oxplot/fpx/configurer/Readme.md

fpx configuration is done via light pulses that is read by the onboard
sensor.

TODO: explanation of the configuration format and encoding
