oxplot/fpx/.github/social.png

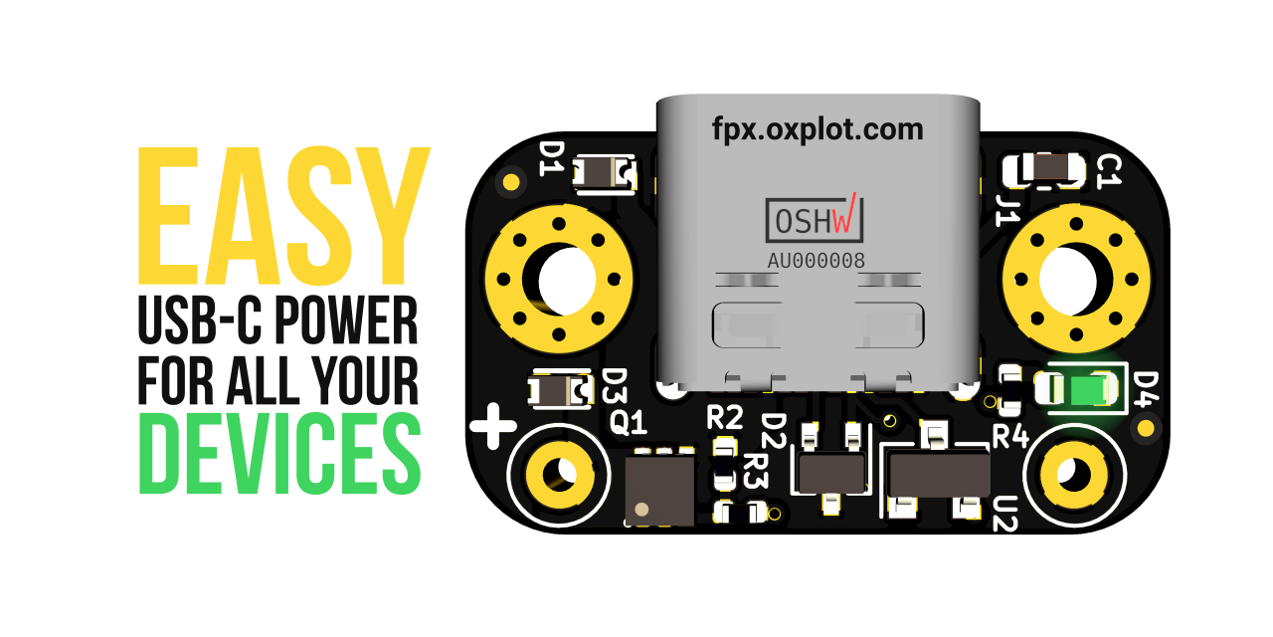
.github/social.png
