oxplot/fpx/configurer/web/fpx.png

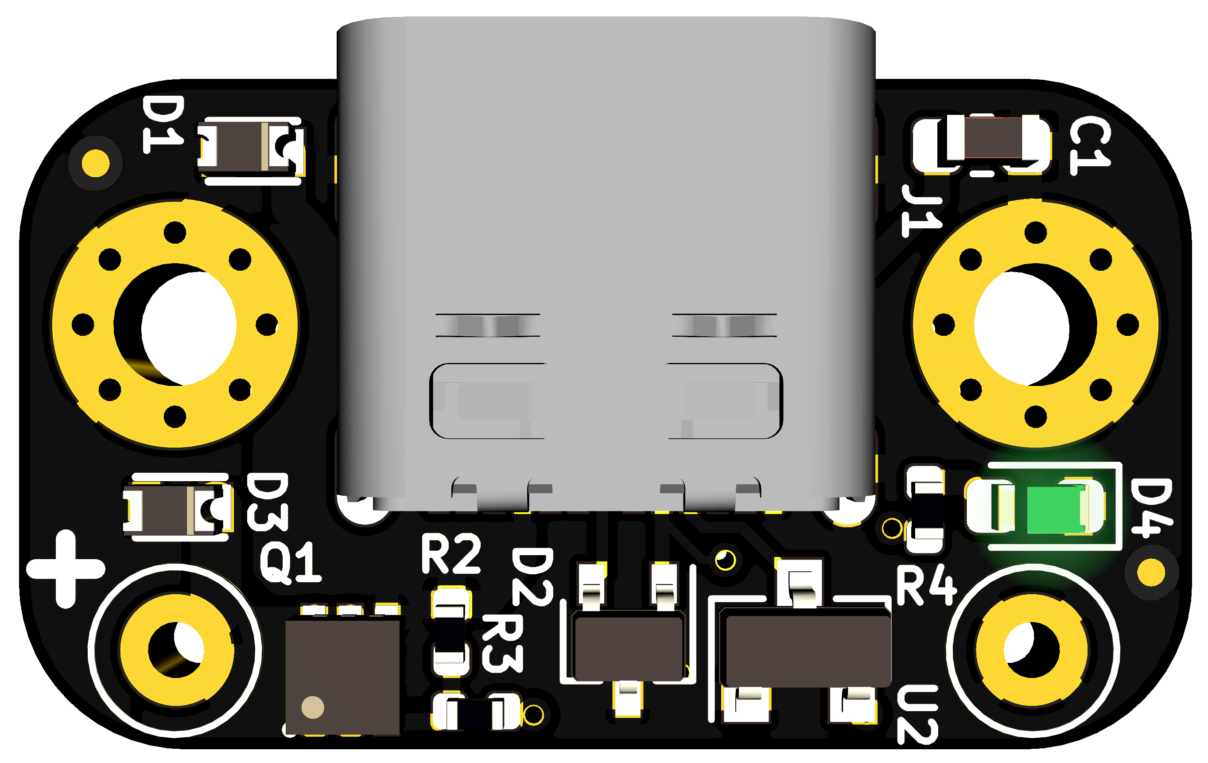
configurer/web/fpx.png
