oxplot/fpx/configurer/web/pwa-screenshot1.png

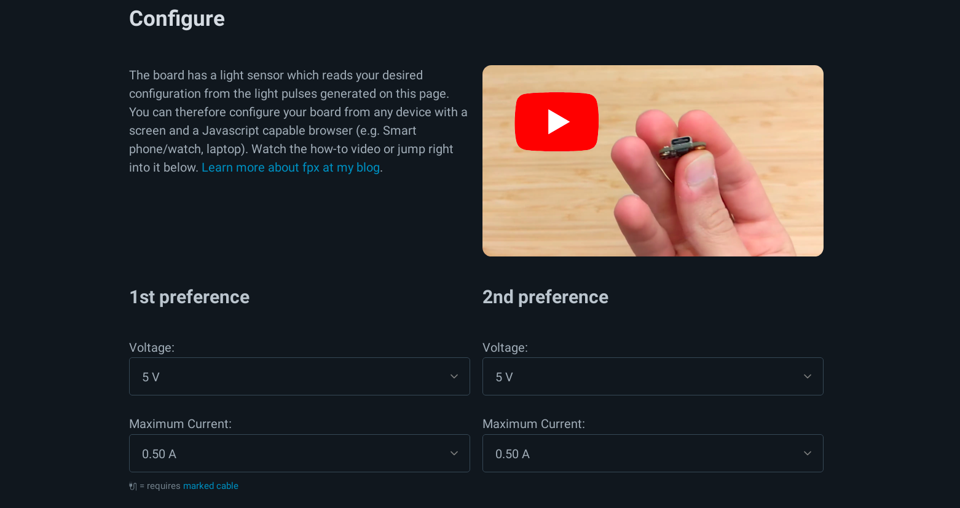
configurer/web/pwa-screenshot1.png
