oxplot/fpx/board/MOLEX_105450-0101.step

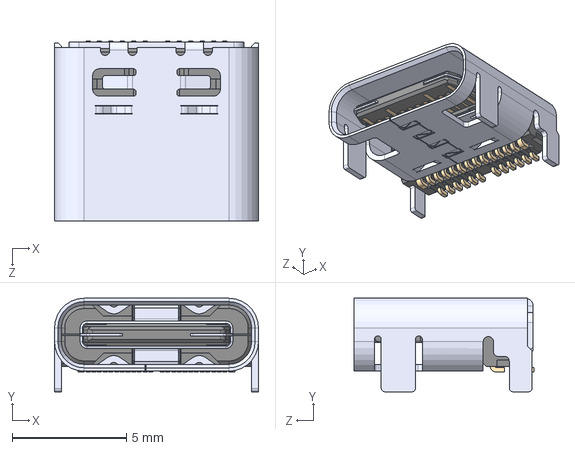
[picture p7: CAD file, 2020-08-21]
board/MOLEX_105450-0101.step
8.94 x 4.10 x 7.90 mm
