oxplot/fpx/programmer/fpx_rev97_prog_jig.step

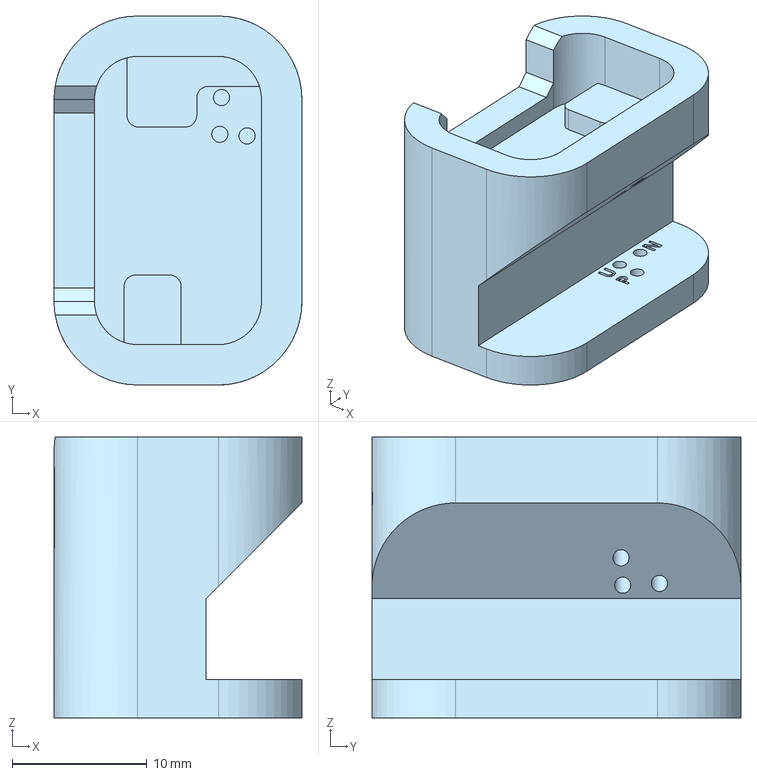
[picture p8: CAD file, 2021-04-24]
programmer/fpx_rev97_prog_jig.step
18.4 x 27.4 x 20.9 mm
