oxplot/fpx/programmer/fpx_rev66_prog_jig.step

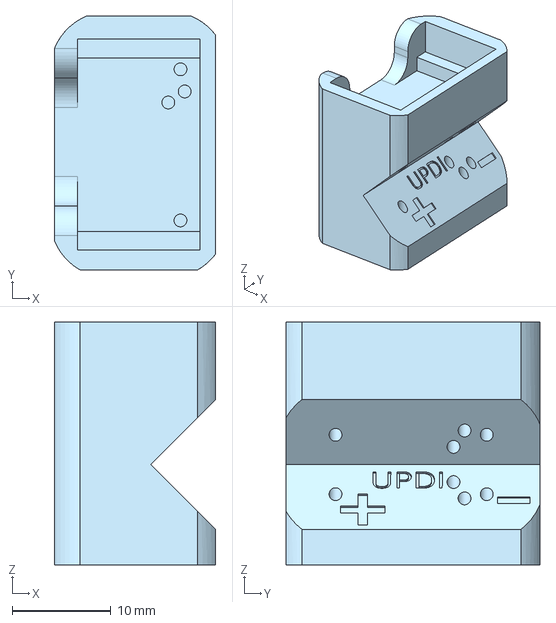
[picture p9: CAD file, 2020-08-21, an earlier design]
programmer/fpx_rev66_prog_jig.step
16.4 x 25.8 x 24.6 mm
