oxplot/fpx/(list of files, cad)

Other CAD files:
programmer/fpx_rev66_prog_jig.stl
programmer/fpx_rev97_prog_jig.stl
