oxplot/fpx/(threads)

Thread 10 (2020-08-27):

Add current limiter and soft-start

oxplot, 2020-08-27:
https://au.element14.com/c/semiconductors-ics/power-management-ics-pmic/power-distribution-switches

https://www.digikey.com/products/en/integrated-circuits-ics/pmic-power-distribution-switches-load-drivers/726

https://www.digikey.com/product-detail/en/stmicroelectronics/VN7140ASTR/497-15994-6-ND/5431502

## Example circuit

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

oxplot, 2020-09-20:
Schematics done in https://github.com/oxplot/fpx/commit/06e6602907f6ecd1e7ba80dc628277a3dda371b2

Closed 2020-09-21.

Thread 11 (2020-08-27):

Add a board level decoupling tantalum capacitor on the VBUS side

oxplot, 2020-08-27:

oxplot, 2020-09-20:
Schematics done in https://github.com/oxplot/fpx/commit/06e6602907f6ecd1e7ba80dc628277a3dda371b2

Closed 2020-09-21.

Thread 14 (2020-09-03):

Backfeeding from Vdrive to Vbus

zoe1337, 2020-09-03:
I was surprised there is no back-to-back MOSFET in the power path - I know this is meant to be a power sink, but if enough bulk capacitance is connected to it, someone might plug it into a port while the caps are still charged.

oxplot, 2020-09-03:
I'd expect the power supply to have its power path protected by a back-to-back MOSFET. Is there any concern of damage to this board?

zoe1337, 2020-09-03:
With standards-compliant devices it should not be an issue.

oxplot, 2020-09-03:
I see. I'll keep this issue as an improvement for the next version. Also, the typical application schematics of STUSB4500 features the back-to-back MOSFET as well:

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

Thanks for bringing this up.

Closed 2022-12-30.

Thread 16 (2020-10-10):

Expose profile selection

edward-shen, 2020-10-10:
Hey!

I was looking through PD controllers and I saw the fpx and I thought this would be a great fit for my project.

I was wondering if it's possible to expose which profile was selected, e.g. through two GPIO pins.

For context, I have some high power portions of my design that has an enable pin that's controlled by a microcontroller and needs a PD controller to negotiate additional power from the USB. If we couldn't negotiate the necessary power, I'd keep these high power portions off and just keep the microcontroller running.

If two pins were exposed (11 for profile 1, 10 for profile 2, and 01 for fallback, for example), the microcontroller would easily be able to decide to power on the high power circuits.

edward-shen, 2020-10-10:
I'm not sure if this is feasible, but it looks like it might be possible to route pin 6 and 7 on the ATTiny and move over R8 and C6 to put pads on the bottom side-- it might be possible to use a through hole footprint instead.

oxplot, 2020-10-10:
Thanks @edward-shen . I've already added two pads which can be programmed to do what you need: https://github.com/oxplot/fpx/issues/15

I'll add exposing selected profile as one of the config options along with things like bidirectional uart logger / controller.

oxplot, 2021-04-28:
@edward-shen the current version of the board (v97) being sold on Tindie has the extra pads (but no firmware support as of now).

Closed 2022-12-30.

Thread 18 (2021-03-03):

Where to find an assembled one?

Le0xFF, 2021-03-03:
This is not really an issue.

Hi, I found you project digging the internet and I find it amazing and it suits perfectly for my project!
The saddest part is that I cannot buy anymore an assembled one from tindie.

My question is where I could buy one on sites like tindie?
I tried to make one, ordering the board from OSHPark and soldering every component by myself, but probably my soldering skills are still not that good!

oxplot, 2021-03-04:
New stock coming in in a month or so.

Closed 2021-03-04.

Thread 24 (2023-04-08):

STUSB4500 burned when connected to 20V USB-C cable

bjkayani, 2023-04-08:
I programmed the unit to give 20V output and connected it to a supply with a USB meter in between. It properly raised the output to 20V. I unplugged the fpx from the meter but since the meter was pulling power, it kept the USB rail at 20V. I then reconnected the fpx and it immediately smoked and the STUSB4500 chip burnt up. The main power draw occurred at Vdd (pin 24).

I am not sure why this happened since the chip is tolerant of 20V but maybe only when its expecting 20V will it be tolerant to it. Maybe the fact that the USB rail was 20V to begin with was unexpected although it should be able to handle that.

I had it working perfectly up till this point and it would program and output voltages properly.

Any ideas of what could have gone wrong? Have you seen anything like this before in your testing?

oxplot, 2023-04-09:
Oooo — sorry to hear that!

I haven't had this happen to me despite using it in the exact setup you're describing. Are you sure it was the STUSB4500 chip that went bust and not some other component?

I can't think of anything that would case the ST chip to draw too much power so fast.

bjkayani, 2023-04-09:
I am sure it was since it was visibly damaged burnt my finger a bit. It also took the uController with it. I replaced both and it is working fine now. I am scared to try to replicate it but will do it for science.

I really like your design and I hope you have plans to bring it back in stock soon. If not, let me know if I can help you with that.

bjkayani, 2023-04-10:
I recreated what I did before and it burned again. Here is a link to the video of it burning up. Maybe you can try to replicate on your end.

[Video Demo](https://photos.app.goo.gl/X7uuMrA85CSuvVx7A)

Could this be because of D5 not working properly? I didnt have the exact part so I bodged in a equivalent SOD-323 schottky. Maybe that is not doing its job.

oxplot, 2023-04-10:
Thanks for that. I really can't tell besides that I have the same USB-C trigger/monitor device. Not sure if that's doing something funky.

I don't actually have any units left and don't have immediate plans to build more ATM.

Closed 2024-08-05.
