oxplot/fpx/(commit log)

2020-08-24 configure/web: add a note about covering the sensor
2020-09-08 Remove fudicials and solder mask offset
    [fpx.kicad_pcb]
2020-09-10 configurer/web: mention over voltage protection
2020-09-20 Add board decoupling cap
    [fpx.sch]
2020-09-21 Update PCB
    - fixes #10
    - fixes #11
    [fpx.kicad_pcb, fpx.sch]
2020-09-21 Update versions
    [fpx.kicad_pcb, fpx.sch]
2020-09-22 Add GPIO headers
    Fixes #15
    [fpx.kicad_pcb, fpx.sch]
2020-09-22 Give mount holes references
    [fpx.kicad_pcb]
2020-09-23 Remove minimum mask req
    [fpx.kicad_pcb]
2020-09-23 Set min solder mask to 5mil
    [fpx.kicad_pcb]
2020-09-25 Keep ground away from vdrive
    [fpx.kicad_pcb]
2020-10-06 wip: add RC circuit for VBUS discharge
    [fpx.kicad_pcb, fpx.sch]
2020-10-13 Add VBUS monitoring RC circuit
    [fpx.kicad_pcb, fpx.sch]
2020-10-14 Fine tune PCB
    [fpx.kicad_pcb, fpx.sch]
2020-10-17 Use a phototran for visible light range
    [fpx.kicad_pcb, fpx.sch]
2021-01-08 Clarify collector/emitter sides of the Q2 for manufacturers
    [fpx.sch]
2021-01-09 Increase heat pad for the mosfet
    [fpx.kicad_pcb]
2021-01-09 Use wire as heatsink by removing thermal relief
    [fpx.kicad_pcb]
2021-01-09 More vdrive improvements
    [fpx.kicad_pcb]
2021-01-09 Mark collector and emitter on PCB
    [fpx.kicad_pcb, fpx.sch]
2021-01-09 Add note for incorrect datasheet for Q2
    [fpx.sch]
2021-01-15 Add manufacturing notes to PCB
    [fpx.kicad_pcb]
2021-01-24 Cosmetic PCB improvements
    [fpx.kicad_pcb]
2021-04-08 Update schematics and PCB previews
2021-04-08 Use SVG for schematics
2021-04-24 Add new programmer 3D models
    [fpx_rev97_prog_jig.step, fpx_rev97_prog_jig.stl]
2021-05-12 Mention adequate cooling for higher output powers
2021-10-04 Add a white background for the schematic
